nishaadh/FreeWheelie/images/progress/Adjustable Arm/setup.jpeg

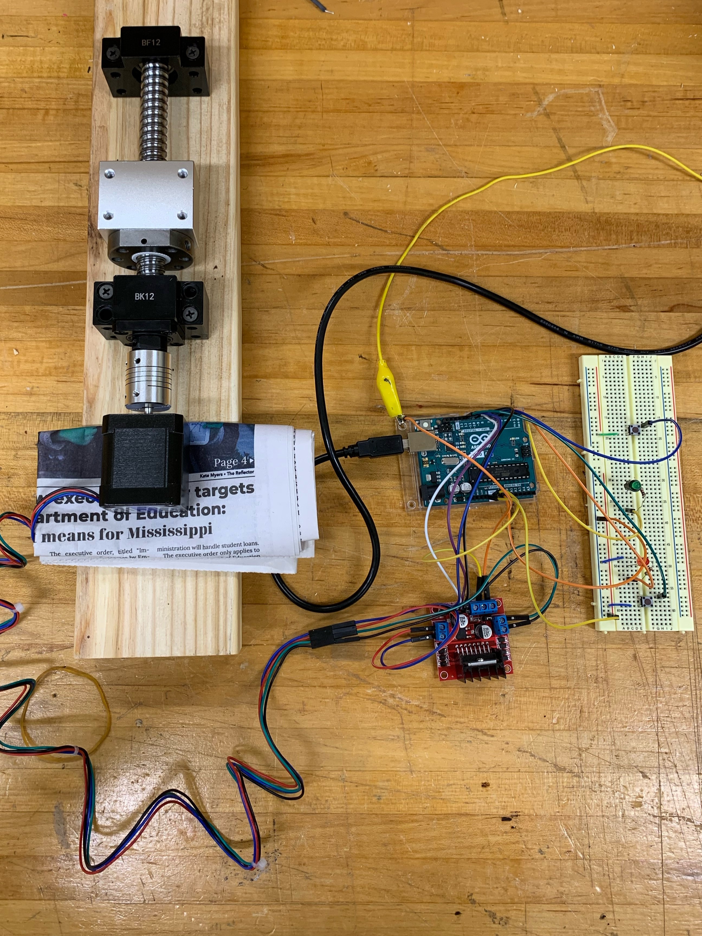
images/progress/Adjustable Arm/setup.jpeg
