nishaadh/FreeWheelie/images/progress/Electronic Wheel/MotorController.png

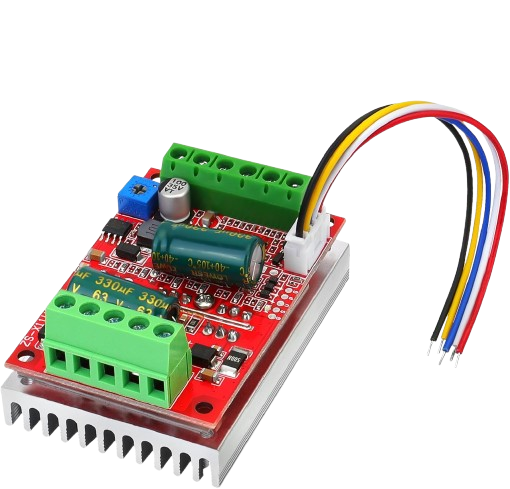
images/progress/Electronic Wheel/MotorController.png
