nishaadh/FreeWheelie/README.md

This is the project repository for Free Wheelie, a senior capstone design project by students from Mississippi State University. Free Wheelie is a conversion kit for a manual wheelchair that adds electronic capabilities. The user can use buttons and joysticks on the installed system to propel the wheelchair the way they want without straining their arms. The members of this project team include Ijerius Brown, Matthew Richards, Mary Claret Landsgaard, Liam Cavanaugh, and Nisha Adhikari. The project advisor is Dr. Masoud Karimi, a professor in the Department of Electrical and Computer Engineering at Mississippi State University.

Access Free Wheelie's project website at https://nishaadh.github.io/FreeWheelie/
