nishaadh/FreeWheelie/images/advisor.jpg

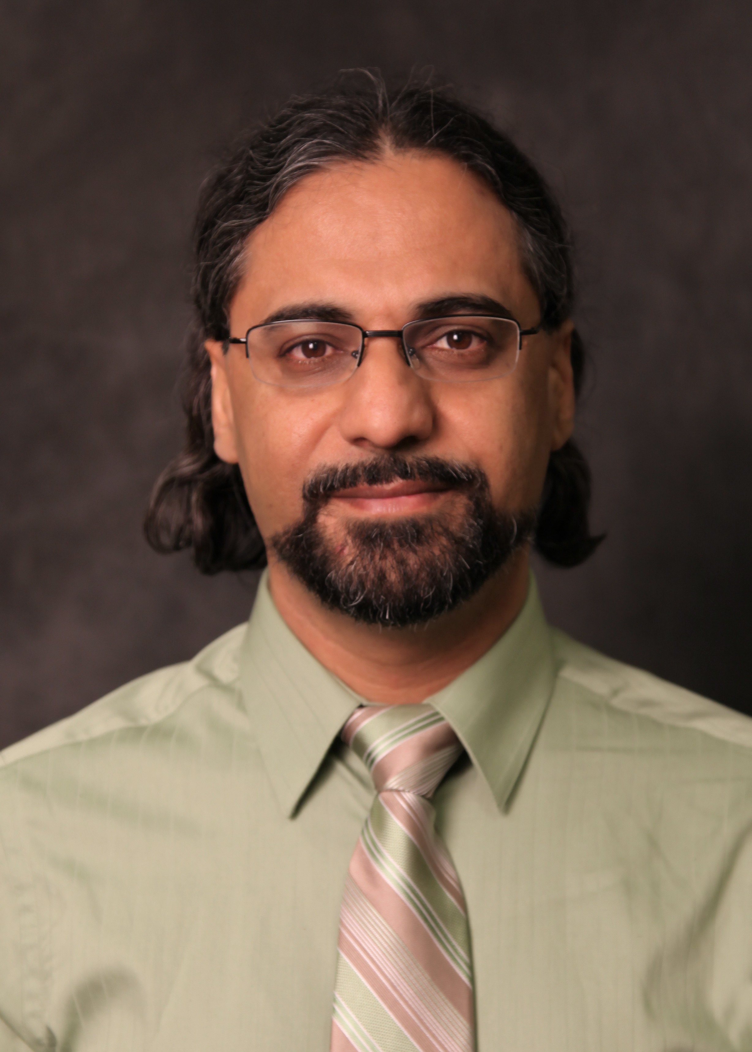
images/advisor.jpg
