nishaadh/FreeWheelie/images/gallery/fulls/01.jpg

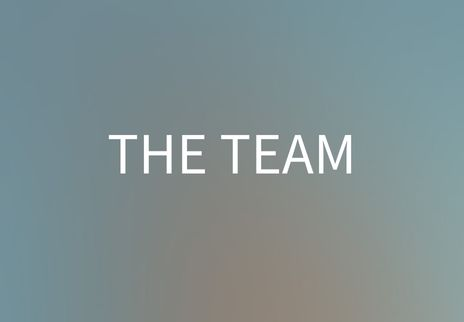
images/gallery/fulls/01.jpg
