nishaadh/FreeWheelie/images/gallery/fulls/02.jpg

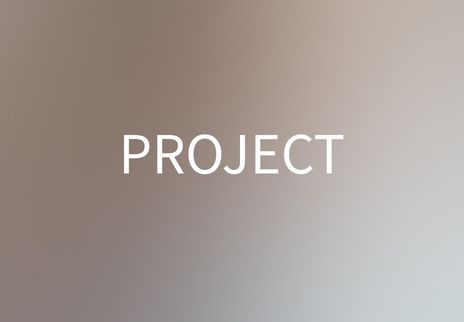
images/gallery/fulls/02.jpg
