nishaadh/FreeWheelie/images/gallery/fulls/03.jpg

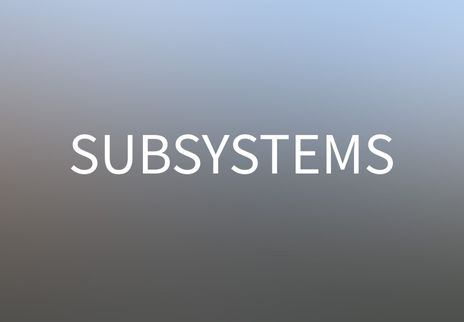
images/gallery/fulls/03.jpg
