nishaadh/FreeWheelie/images/gallery/fulls/04.jpg

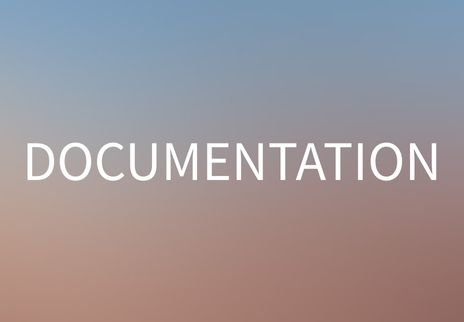
images/gallery/fulls/04.jpg
