nishaadh/FreeWheelie/images/member1.jpg

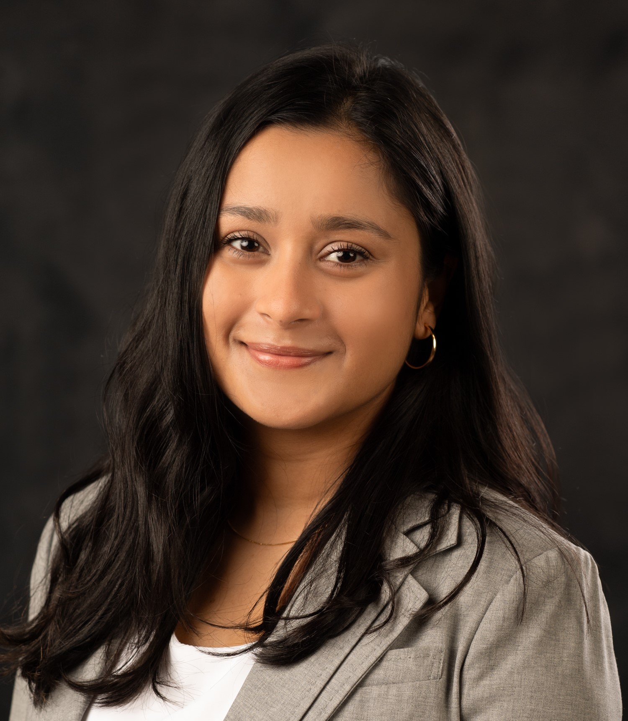
images/member1.jpg
