nishaadh/FreeWheelie/images/member2.jpeg

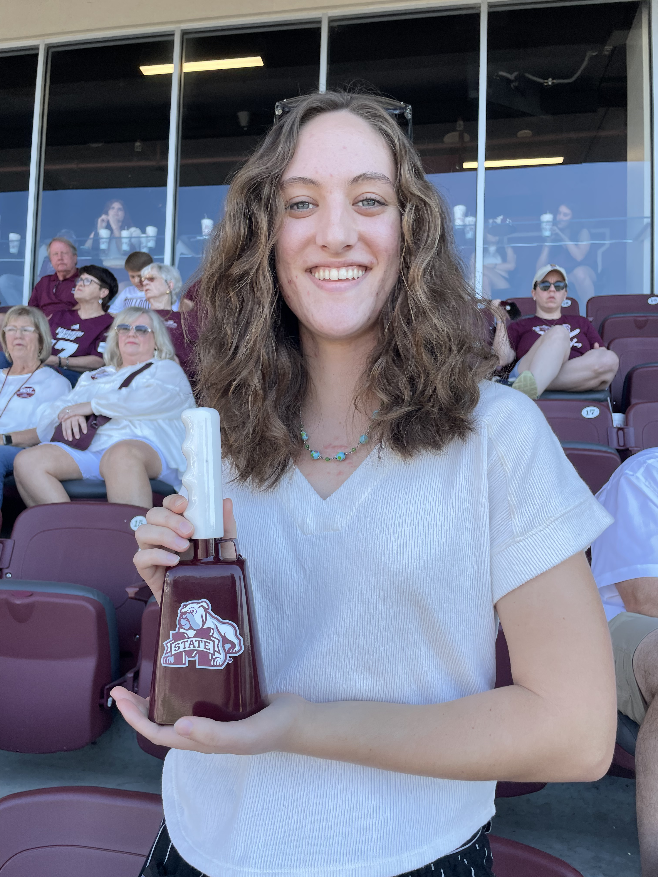
images/member2.jpeg
