nishaadh/FreeWheelie/images/member3.jpeg

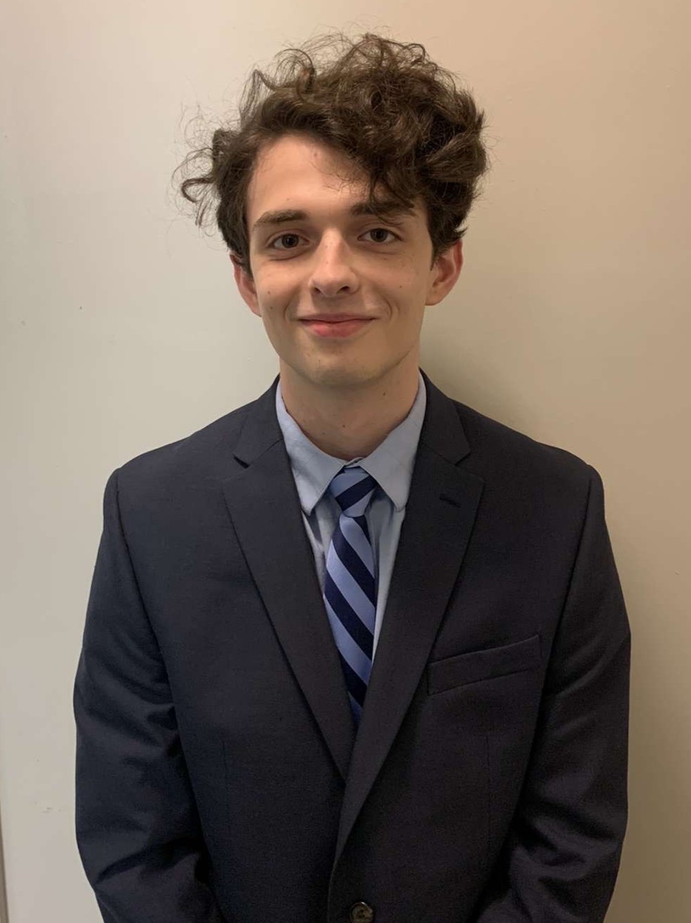
images/member3.jpeg
