nishaadh/FreeWheelie/images/member4.jpg

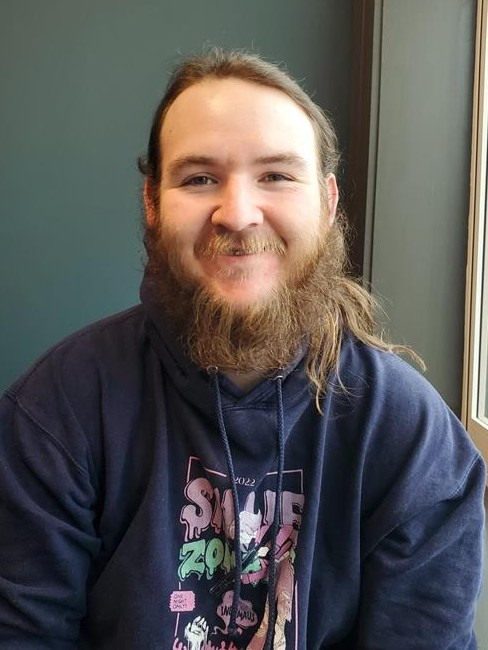
images/member4.jpg
