nishaadh/FreeWheelie/images/member5.jpeg

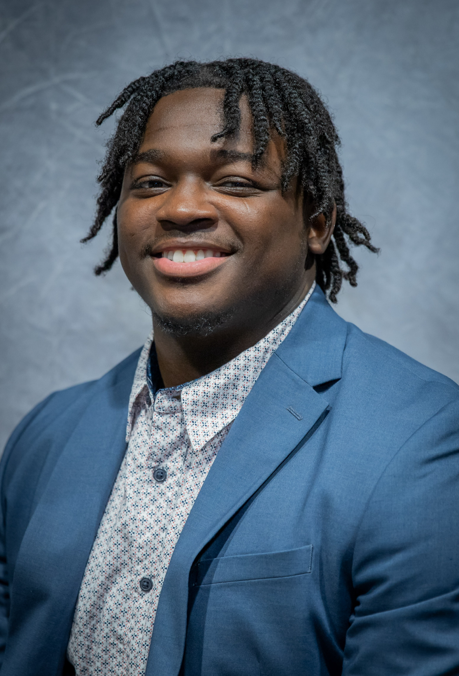
images/member5.jpeg
