nishaadh/FreeWheelie/images/member.jpg

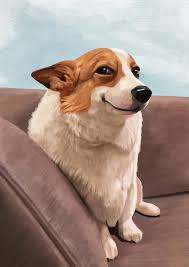
images/member.jpg
