nishaadh/FreeWheelie/images/progress/Adjustable Arm/stepper.png

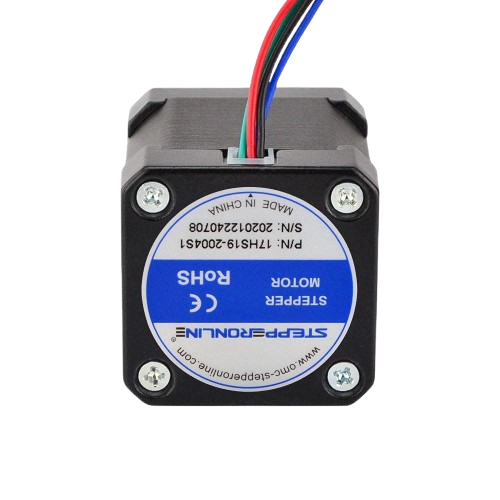
images/progress/Adjustable Arm/stepper.png
