nishaadh/FreeWheelie/images/progress/Electronic Wheel/Hub_Motor.png

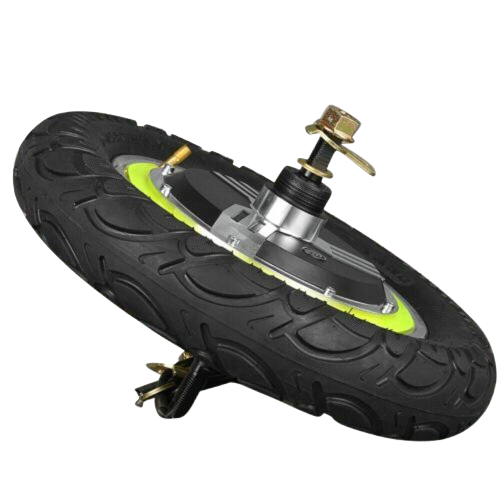
images/progress/Electronic Wheel/Hub_Motor.png
