nishaadh/FreeWheelie/images/progress/Electronic Wheel/Stepper.png

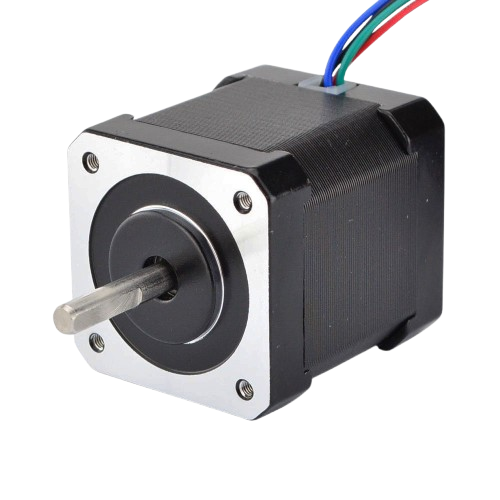
images/progress/Electronic Wheel/Stepper.png
