nishaadh/FreeWheelie/images/progress/UI & Controls/joystick.jpg

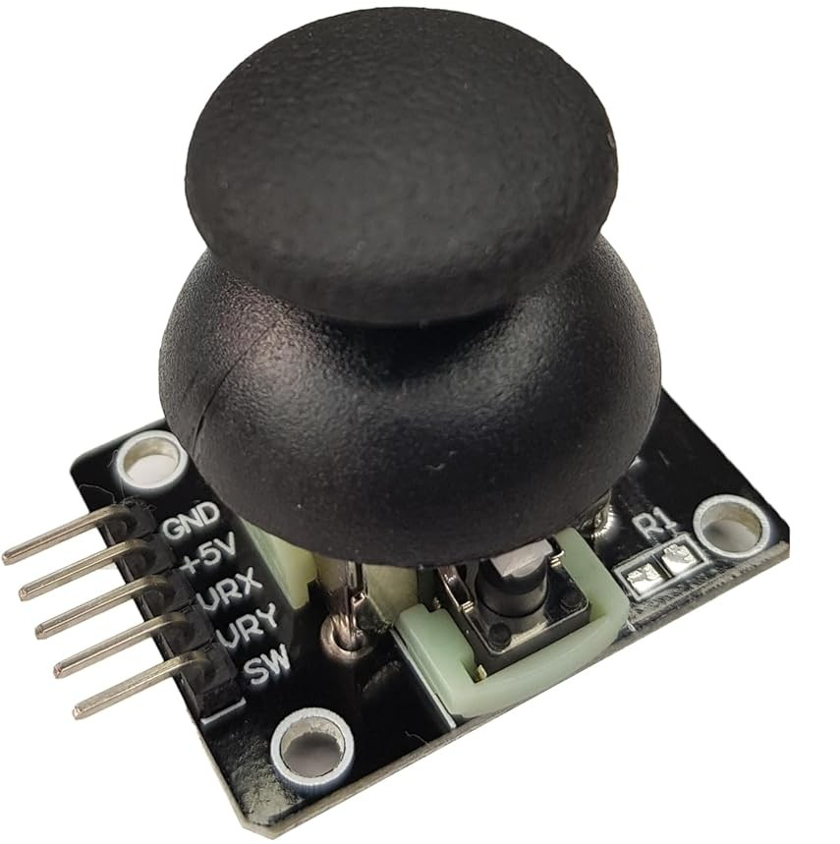
images/progress/UI & Controls/joystick.jpg
