nishaadh/FreeWheelie/images/progress/UI & Controls/LCD_01.jpeg

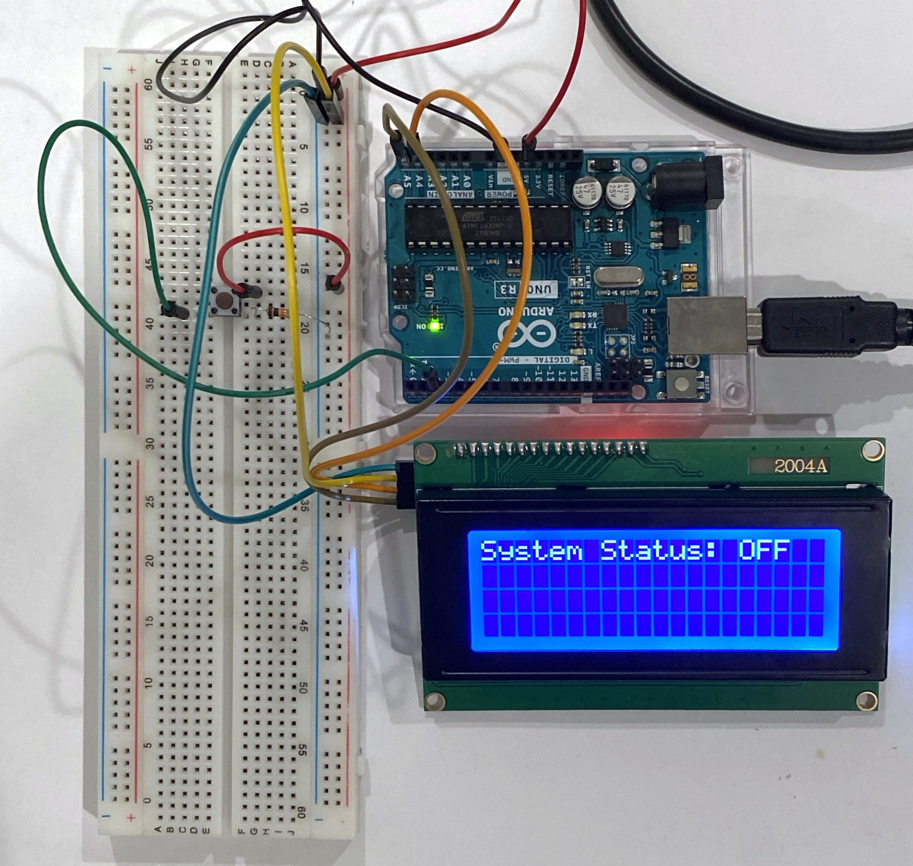
images/progress/UI & Controls/LCD_01.jpeg
