nishaadh/FreeWheelie/images/progress/UI & Controls/LCD_02.jpeg

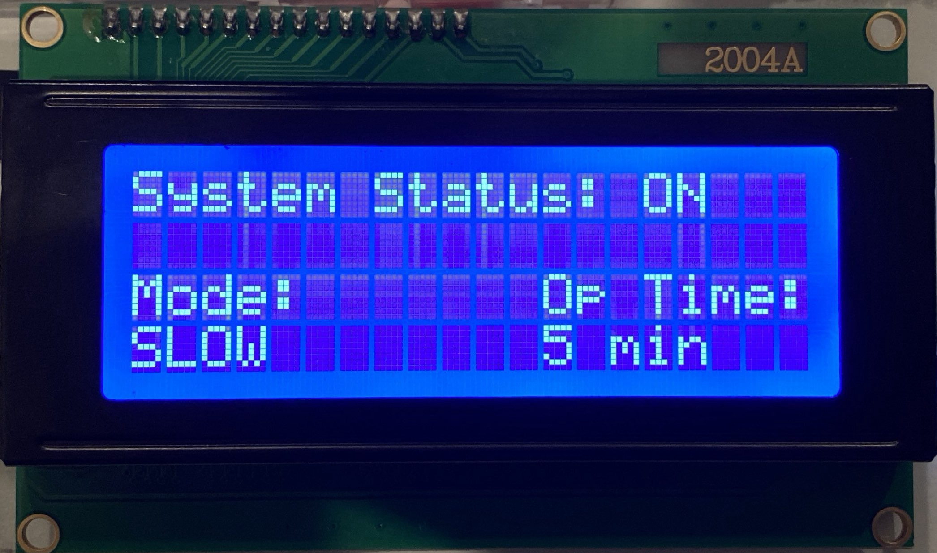
images/progress/UI & Controls/LCD_02.jpeg
