nishaadh/FreeWheelie/images/progress/UI & Controls/LCD_03.jpeg

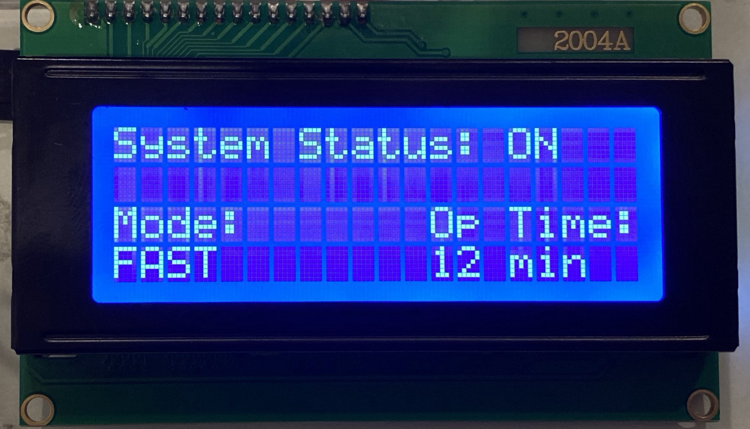
images/progress/UI & Controls/LCD_03.jpeg
