nishaadh/FreeWheelie/images/progress/Electronic Wheel/Setup.jpg

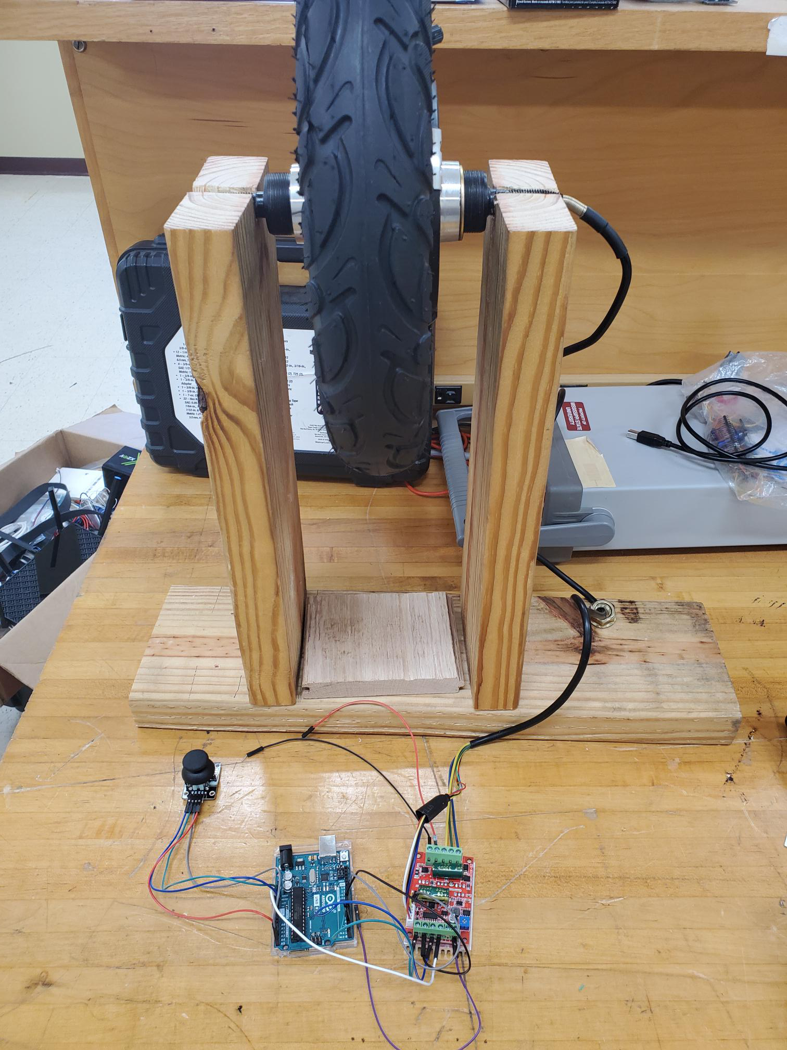
images/progress/Electronic Wheel/Setup.jpg
